maximkonovalov007/heartbeat/brand/cover.png

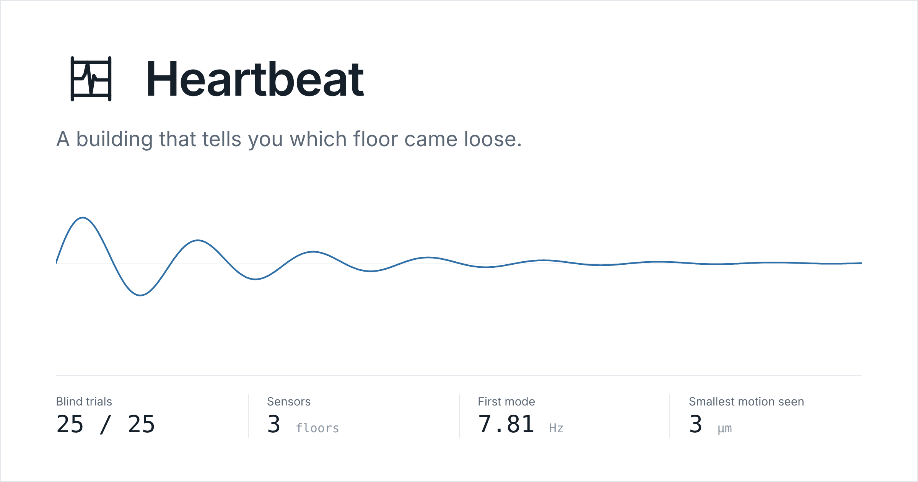
brand/cover.png
